DeMarco/MAU-1.0/Hardware/Gerbers/Altimeter6 - bottom.jpg

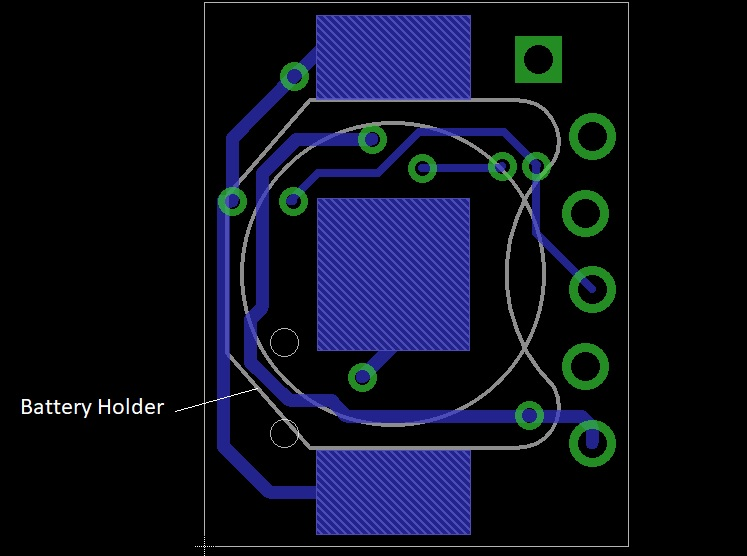
Hardware/Gerbers/Altimeter6 - bottom.jpg
