DeMarco/MAU-1.0/Hardware/Gerbers/Altimeter6 - top.jpg

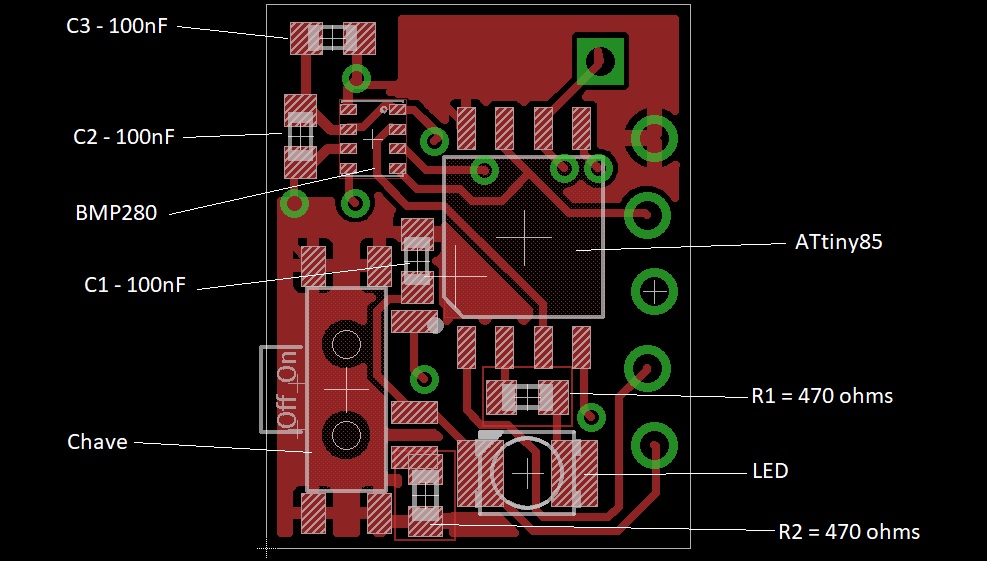
Hardware/Gerbers/Altimeter6 - top.jpg
