DeMarco/MAU-1.0/Hardware/Gerbers/Schematic Adapter.JPG

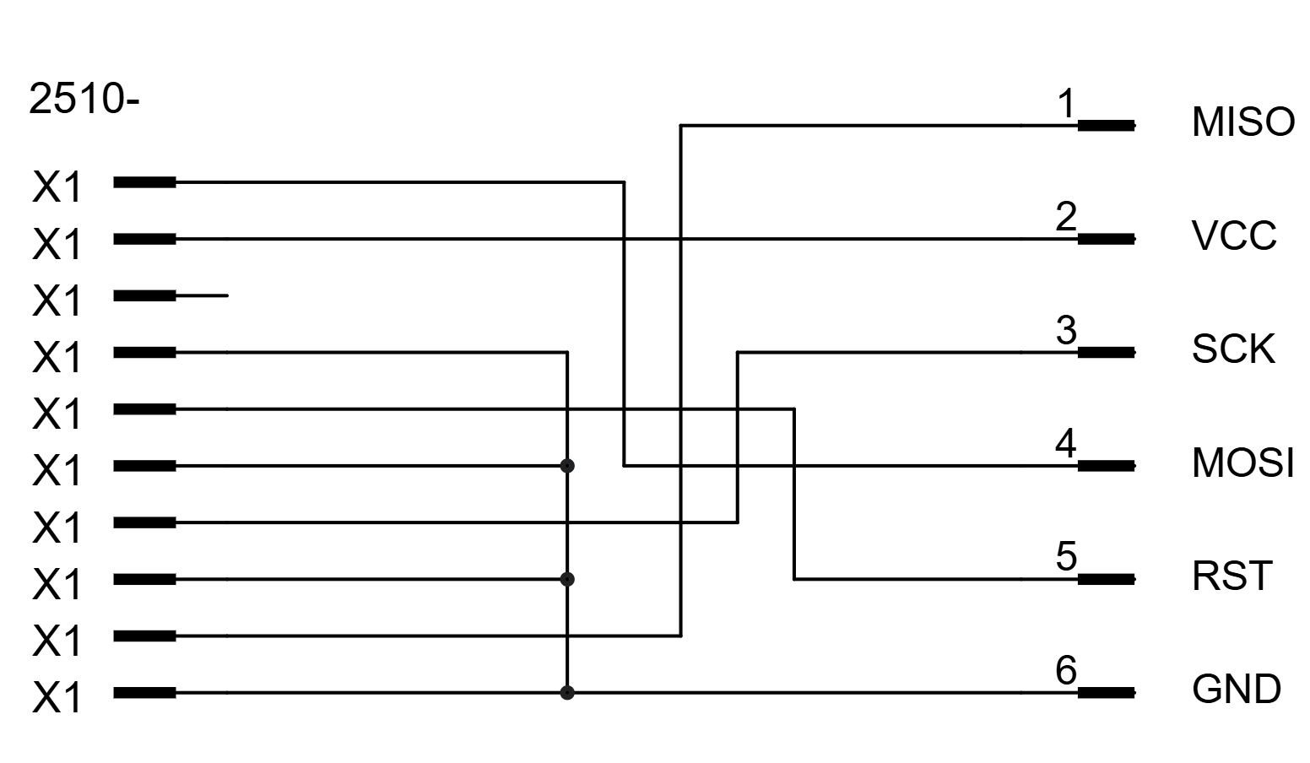
Hardware/Gerbers/Schematic Adapter.JPG
