DeMarco/MAU-1.0/Hardware/Gerbers/Schematic Altimeter.JPG

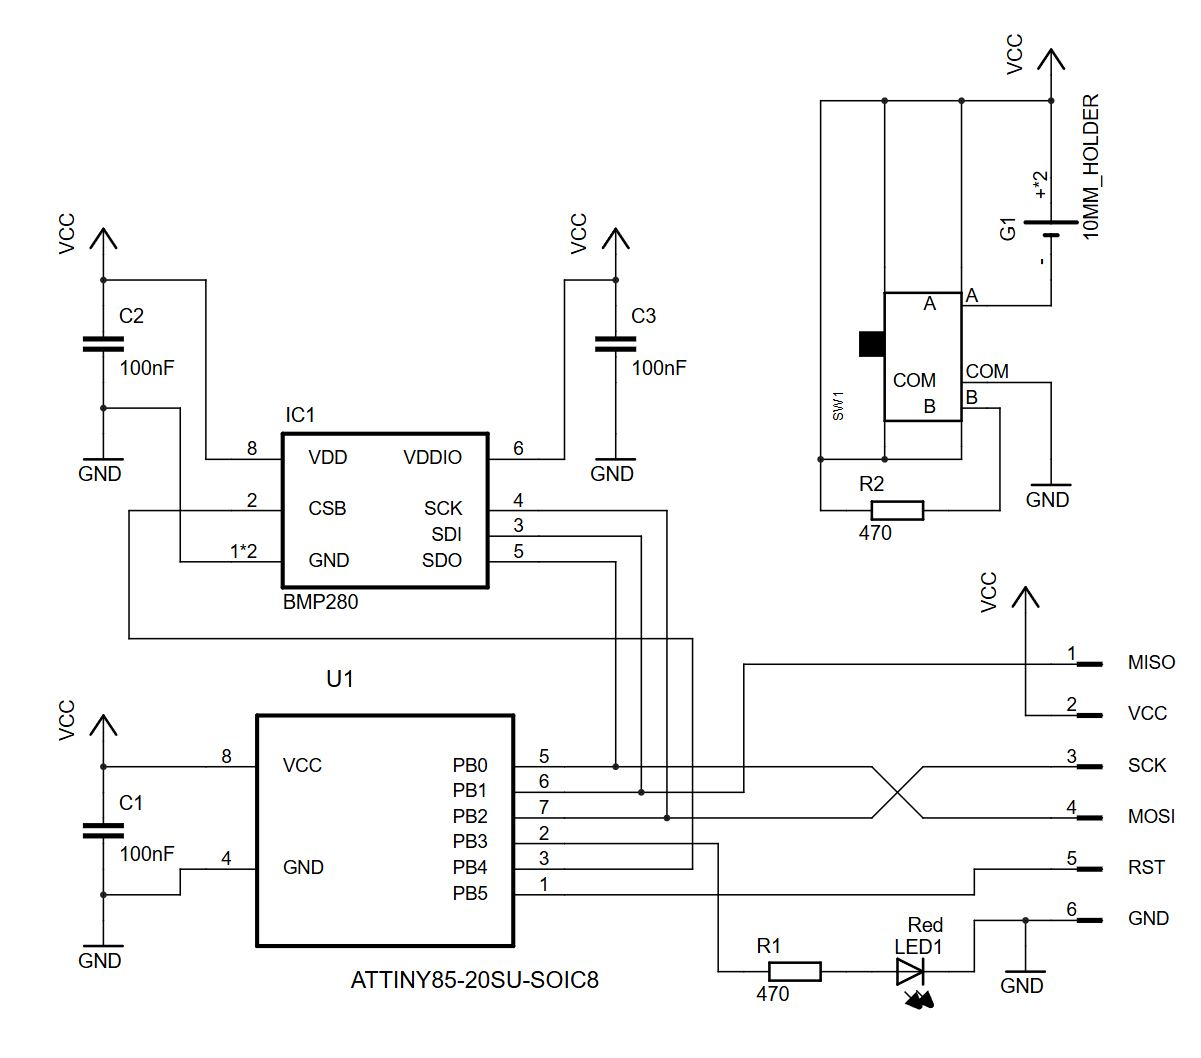
Hardware/Gerbers/Schematic Altimeter.JPG
