DeMarco/MAU-1.0/Hardware/ISP Bottom.jpg

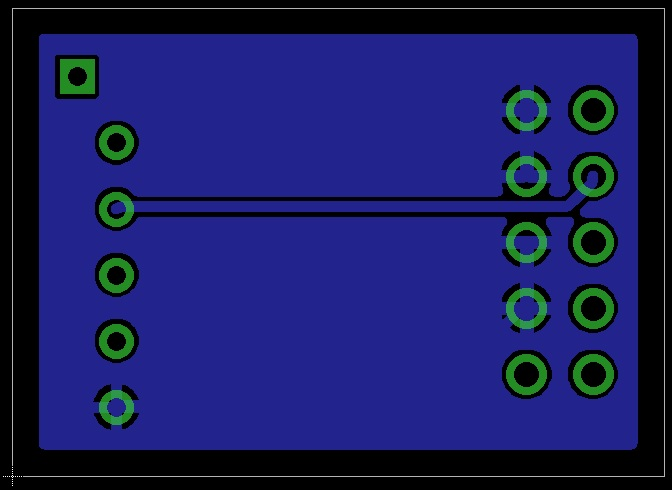
Hardware/ISP Bottom.jpg
