DeMarco/MAU-1.0/Hardware/ISP Top.jpg

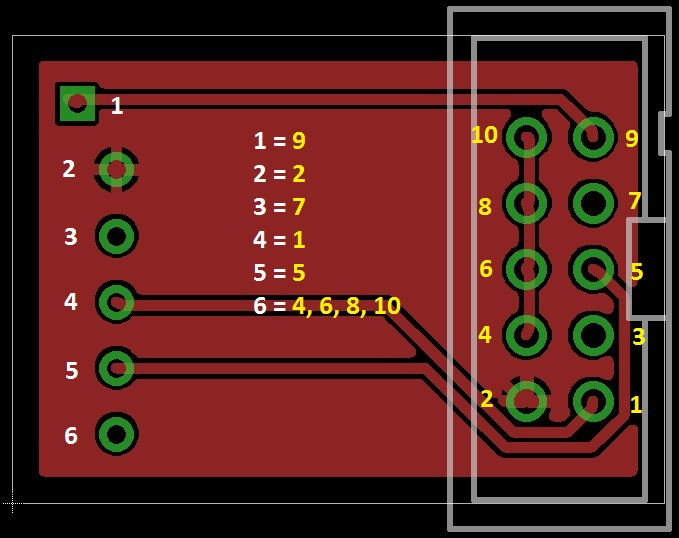
Hardware/ISP Top.jpg
