DeMarco/MAU-1.0/Hardware/Gerbers/lista de componentes MAU.xlsx

 | Descrição | Modelo | Package | Fabricante | Quantidade por placa
ALTÍMETRO | Barômetro | BMP280 | LGA | Bosch | 1
 | Bateria | CR1025 |  | Panasonic | 1
 | Holder Bateria | BK-870 |  | Memory Protection Devices | 1
 | Microcontrolador | ATTINY85-20SU | SOIC8 | Microchip | 1
 | Capacitor | 100nF | 0603 |  | 3
 | Resistor | 470R | 0603 |  | 2
 | LED | Vermelho | 3528 |  | 1
 | Chave | SSSS811101 |  | ALPS | 1
ADAPTADOR | Conector 10 pinos 3M | 2510-6002UB |  | 3M | 1
 | Pinos (daqueles de barra de pino) |  |  |  | 6
