DeMarco/MAU-1.0/Delivery_Montagem/Leitor_MAU/Leitura Dados De Vôo.xlsm

Sheet: Modelo Atmosférico
Equação Barométrica
P (input) | 101523 |  | 101323.8
h (output) | -16.5
h (input) | 950
P (output) | 90531.76
EQ1_Tb | 288.15 | 15
EQ1_Lb | -0.0065
EQ1_R | 8.31432
EQ1_g | 9.80665
EQ1_M | 0.0289644
EQ1_Pb | 101325
coef1 | 44307
index1 | 0.2119
coef2 | 44330
index2 | 0.1903

Sheet: Leitura Dados de Vôo
Vôo Nº: |  | Data:
 |  |  | Altitude (m)
Pressão no Solo (Pa) |  | 101324,27 | #VALUE! | Apogeu (m)
Pressão no Apogeu (Pa) |  | 101324,27 | #VALUE! | #VALUE!
 | Altímetro
Tempo (s) | Dados Brutos | Pressao | Altitude | Altura
0 |  |  | 0.0 | 0.0
0.192 |  |  | 0.0 | 0.0
0.384 |  |  | 0.0 | 0.0
0.576 |  |  | 0.0 | 0.0
0.768 |  |  | 0.0 | 0.0
0.96 |  |  | 0.0 | 0.0
1.152 |  |  | 0.0 | 0.0
1.344 |  |  | 0.0 | 0.0
1.536 |  |  | 0.0 | 0.0
1.728 |  |  | 0.0 | 0.0
1.92 |  |  | 0.0 | 0.0
2.112 |  |  | 0.0 | 0.0
2.304 |  |  | 0.0 | 0.0
2.496 |  |  | 0.0 | 0.0
2.688 |  |  | 0.0 | 0.0
2.88 |  |  | 0.0 | 0.0
3.072 |  |  | 0.0 | 0.0
3.264 |  |  | 0.0 | 0.0
3.456 |  |  | 0.0 | 0.0
3.648 |  |  | 0.0 | 0.0
3.84 |  |  | 0.0 | 0.0
4.032 |  |  | 0.0 | 0.0
4.224 |  |  | 0.0 | 0.0
4.416 |  |  | 0.0 | 0.0
4.608 |  |  | 0.0 | 0.0
4.8 |  |  | 0.0 | 0.0
4.992 |  |  | 0.0 | 0.0
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
