DeMarco/MAU-1.0/Notes/accuracy verification.txt

y-y0 = m(x-x0)
h-h0 = m(p-p0)
h = m(p-p0) + h0

90678 = 933 -> 926.6
91262 = 879 -> 873.5

53.5 -> 53.1

89547 = 1036 -> 1030.1
91384 = 868  -> 862.5

168.4 -> 167.6

91226 -> 876.8
91443 -> 857.1

153

839.8
843.6

38

951.9

9349

37

156.5

917

1071

1148

7132

1083

120.8

110.3

1533

1533

141

16
