DeMarco/MAU-1.0/Notes/Teste SPI BMP280.txt

00100111 - CTRL_MEAS
01001000 - CONFIG
01011000 - ID
00000000 - STATUS

01010111 - Press
11100011 - Press
00000000 - Press

123
750
554
359

11111111 11111111 11111111

00100100
00000001
01111111
10111111
11011111
00011111
11100000

00001100
11100000
00000000

01000100
11100000
01000000

2

00000001
