DeMarco/MAU-1.0/(threads)

Thread 8 (2023-03-02):

Sample Rate Change register in EEPROM is not initialized

DeMarco, 2023-03-02:
Sample Rate Change Address register in EEPROM not initialized, and GraphGenerator doesn't check if the value is valid before using it.
Also, if the currently stored flight data didn't need a reduction in sample rate, the Sample Rate Change Address will still contain an address from the last flight that did use a reduced sample rate. This way, the Graph Generator might apply a change in sample rate and timestamps that should not exist.
