DeMarco/MAU-1.0/Hardware/MAU1.brd

## EAGLE design Hardware/MAU1.brd (2018-09-09)

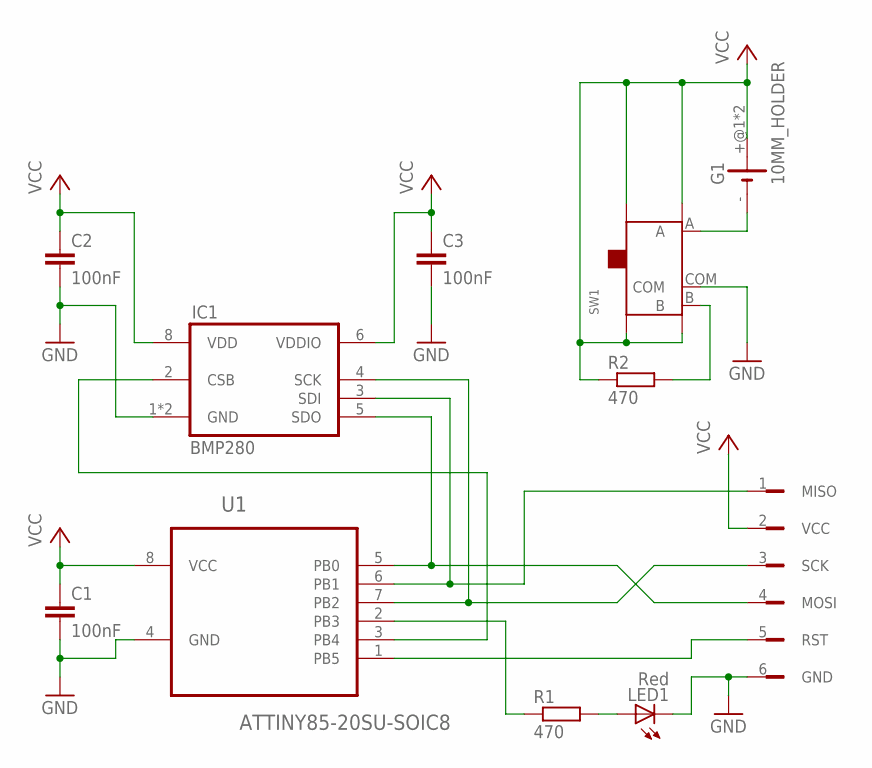
[picture p7: schematic MAU1.sch]

Parts:
C1, C2, C3: 100nF; C0603K
G1: 10MM_HOLDER
IC1: BMP280
LED1: Red; KA-3528ASYC
R1, R2: 470; R0603
SW1: SMD-TOGGLE-SWITCH-ON-ON(3+4P-6.7X2.7MM)SLIDE_LATE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; SW7-SMD-6.7X2.6X1.4MM-90D
U1: ATTINY85-20SU-SOIC8; SOIC8-1.27-5.3X5.3MM
U$1: ISP_CONN_6_FDRILL16; ISP_CONN_6_F_DRILL16

Connections:
GND: C1.2, C2.2, C3.2, IC1.1 (GND), IC1.7 (GND), LED1.C, SW1.COM, U1.4 (GND), U$1.6 (GND)
unnamed: G1.-, SW1.A
unnamed: R1.1, U1.2 (PB3)
unnamed: U1.1 (PB5), U$1.5 (RST)
unnamed: LED1.A, R1.2
unnamed: IC1.2 (CSB), U1.3 (PB4)
unnamed: R2.2, SW1.B
unnamed: IC1.4 (SCK), U1.7 (PB2), U$1.3 (SCK)
unnamed: IC1.3 (SDI), U1.6 (PB1), U$1.1 (MISO)
unnamed: IC1.5 (SDO), U1.5 (PB0), U$1.4 (MOSI)
VCC: C1.1, C2.1, C3.1, G1.+@1 (+), G1.+@2 (+), IC1.6 (VDDIO), IC1.8 (VDD), R2.1, SW1.P1 (SS4), SW1.P2 (SS3), SW1.P3 (SS2), SW1.P4 (SS1), U1.8 (VCC), U$1.2 (VCC)

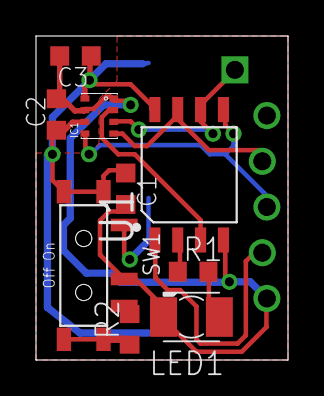
[picture p8: board MAU1.brd from above]

Board: 2 copper layers, 14.0 x 18.0 mm, 11 parts (0 on the bottom side), 11 nets.
