DeMarco/MAU-1.0/Firmware/MainDev/FlightProfile_130.h

// Based on the top part of Uranos flight, between 8 and 22 seconds
// + 40 initial samples for ground pressure averaging:


const uint16_t pressure_samples[] PROGMEM = {

  //Initial samples for ground pressure averaging:
  28259,
  28258,
  28259,
  28257,
  28258,
  28259,
  28258,
  28259,
  28257,
  28258,
  28259,
  28258,
  28259,
  28257,
  28258,
  28259,
  28258,
  28259,
  28257,
  28258,
  28259,
  28258,
  28259,
  28257,
  28258,
  28259,
  28258,
  28259,
  28257,
  28258,
  28259,
  28258,
  28259,
  28257,
  28258,
  28259,
  28258,
  28259,
  28257,
  28258,

  //Recorded flight:
  28259,
  28287,
  28320,
  28347,
  28373,
  28400,
  28425,
  28445,
  28465,
  28484,
  28501,
  28515,
  28529,
  28542,
  28553,
  28563,
  28572,
  28579,
  28585,
  28589,
  28592,
  28591,
  28591,
  28648,
  28671,
  28648,
  28678,
  28637,
  28621,
  28615,
  28610,
  28595,
  28593,
  28585,
  28582,
  28578,
  28573,
  28573,
  28565,
  28561,
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

};
