DeMarco/MAU-1.0/Firmware/MainDev/FlightProfile_500.h

// Based on the top part of Uranos flight, between 8 and 22 seconds
// + 27 initial samples for ground pressure averaging:


const uint16_t pressure_samples[] PROGMEM = {

  //Initial samples for ground pressure averaging:
  24100,
  24101,
  24102,
  24101,
  24100,
  24099,
  24098,
  24099,
  24100,
  24101,
  24102,
  24101,
  24100,
  24099,
  24098,
  24099,
  24100,
  24101,
  24102,
  24101,
  24100,
  24099,
  24098,
  24099,
  24100,
  24101,
  24102,
  24101,

  //Recorded flight:
  24100,
  24200,
  24300,
  24400,
  24500,
  24600,
  24700,
  24800,
  24900,
  25000,
  25100,
  25200,
  25300,
  25400,
  25500,
  25600,
  25700,
  25800,
  25900,
  26000,
  26100,
  26180,
  26260,
  26330,
  26400,
  26450,
  26500,
  26487,
  26474,
  26461,
  26448,
  26435,
  26422,
  26409,
  26396,
  26383,
  26370,
  26357,
  26344,
  26331,
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

};
