DeMarco/MAU-1.0/Firmware/MainDev/FlightProfile_Urano.h

// Based on the 214 first raw pressure samples of the Urano flight
// + 30 initial samples for ground pressure averaging:


const uint16_t pressure_samples[] PROGMEM = {

  //Initial samples for ground pressure averaging:
  25097,
  25097,
  25098,
  25099,
  25100,
  25101,
  25100,
  25099,
  25098,
  25097,
  25097,
  25098,
  25099,
  25100,
  25101,
  25092,
  25092,
  25093,
  25094,
  25095,
  25096,
  25095,
  25094,
  25093,
  25092,
  25092,
  25093,
  25094,
  25095,
  25096,

  //Recorded flight:
  25096,
  25082,
  25053,
  24853,
  24913,
  25050,
  25220,
  25384,
  25557,
  25708,
  25858,
  25986,
  26128,
  26242,
  26368,
  26479,
  26585,
  26697,
  26797,
  26892,
  26982,
  27070,
  27155,
  27234,
  27315,
  27381,
  27458,
  27525,
  27591,
  27654,
  27713,
  27770,
  27824,
  27881,
  27931,
  27979,
  28022,
  28069,
  28108,
  28153,
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

};
