DeMarco/MAU-1.0/Firmware/MainDev/AtmosModel_100_v3.h

// Atmospheric model for altimeter
// Linear approximation with 100 intervals
// Range: 30 kPa (9165.4 m) to 110 kPa (-698.4 m)
// Formula: h = (T0/L0)*(pow((P/P0),((-R*L0)/(g*M)))-1)
// Assumptions:	P0 = 101325 Pa
//					    g = 9,80665 m/s^2
//					    T0 = 15 degC
//					    L0 = -0,0065 K/m
//					    R = 8,31432 N*m/Mol*K
//					    M = 0,0289644 kg/Mol

#define SENSOR_MAX_PRESSURE 	  110000	//Pa
#define SENSOR_MIN_PRESSURE 	  30000	  //Pa
#define PRESSURE_STEP		        800		  //Pa
#define NUMBER_OF_INTERVALS     100
#define NUMBER_OF_BREAKPOINTS	  NUMBER_OF_INTERVALS + 1

const float height_array[NUMBER_OF_BREAKPOINTS] PROGMEM = {
-698.3,
-635.8,
-573.0,
-509.7,
-446.1,
-382.1,
-317.7,
-252.9,
-187.7,
-122.1,
-56.0,
10.4,
77.3,
144.6,
212.3,
280.5,
349.2,
418.3,
487.9,
557.9,
628.4,
699.4,
770.9,
842.9,
915.5,
988.5,
1062.1,
1136.2,
1210.8,
1286.0,
1361.8,
1438.1,
1515.0,
1592.6,
1670.7,
1749.4,
1828.8,
1908.8,
1989.4,
2070.7,
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
};
