DeMarco/MAU-1.0/Firmware/PrototypeOne/AtmosModel_100.c

// Atmospheric model for altimeter
// 100 elements piece-wise linear aproximation
// Range: 30 kPa (9165.4 m) to 110 kPa (-698.4 m)
// Equation: h = 44330 * (1 - pow(P/P0, 0.1903))
// Considerations:	P0 = 101325 Pa
//					g = 9,80665 m/s^2
//					T0 = 15ºC
//					L0 = -0,0065 K/m
//					R = 8,31432 N*m/Mol*K
//					M = 0,0289644 kg/Mol

uint32_t press_max = 110000, press_min = 30000;

float h_breakpoints[101] = {
-698.4,
-635.9,
-573.1,
-509.8,
-446.2,
-382.2,
-317.7,
-252.9,
-187.7,
-122.1,
-56.0,
10.4,
77.3,
144.6,
212.4,
280.6,
349.2,
418.4,
487.9,
558.0,
628.5,
699.5,
771.1,
843.1,
915.6,
988.7,
1062.3,
1136.4,
1211.0,
1286.2,
1362.0,
1438.4,
1515.3,
1592.8,
1671.0,
1749.7,
1829.1,
1909.1,
1989.7,
2071.0,
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
};
