DeMarco/MAU-1.0/(commit log)

2018-07-29 Commiting project relevant files
    [CALCULO TEMP.xlsx, Calculos.xlsx, Formulas de altitude e pressào.xlsx, Leitura Dados De Vôo - 2.xlsx, Leitura Dados De Vôo.xlsm, PiecewiseLinear.xls, TEMPLATE - Leitura Dados De Vôo.xlsx]
2018-07-29 Moved to correct folder in PC
    [CALCULO TEMP.xlsx, Calculos.xlsx, Formulas de altitude e pressào.xlsx, Leitura Dados De Vôo - 2.xlsx, Leitura Dados De Vôo.xlsm, PiecewiseLinear.xls, TEMPLATE - Leitura Dados De Vôo.xlsx]
2018-08-17 Moved stuff to Notes folder
    [CALCULO TEMP.xlsx, Calculos.xlsx, Formulas de altitude e pressào.xlsx, PiecewiseLinear.xls]
2018-09-09 Brought HW project to main repo
    [ISP_adapter2.brd, ISP_adapter2.sch, MAU1.brd, MAU1.sch]
2019-02-02 Prepared MainDev project for continuing development. PrototypeOne is now a frozen version of the firmware of MAU-1.0 currently released to production.
2019-02-02 Placing fluxogram files at MainDev, PrototypeOne and GraphGenerator folders
2019-02-03 Translated firmware comments and flowcharts
2019-02-03 Deleted old portuguese firmware flowcharts
2019-02-04 Update MAIN FLOWCHART.html
    Included step for saving barometers calibration constants before auto shut down.
2019-02-10 Fixed bugs caused by the renaming of def constants in the atmospheric model header. Added batches to MainDev folder for quickly flashing the firmware and erasing the EEPROM.
    [main.c]
2019-02-10 Added comment questioning the zeroing (in meters) of the first sample in the NVM.
2019-03-03 Updated Main Flowchart with method to calculate Initial Ground Pressure and Landing Detection based on 20 raw pressure samples variance.
2019-03-03 Fixed landing detection condition to be just "variance < value", since variance can never be negative.
    [main.c]
2019-07-12 Flex Sampling Rate new feature merge (#7)
    * Strategy for parachute descent detection and sampling rate reduction.
    * Preparations for flexible sampling rate implementation. TESTS OK.
    * Average pressure change rate based variance calculation is ready.
    * Pressure change rate + its variance as conditions for landing detection. In the current state, the program works fine for tests in the glass jar (thus, expected to work for short quick flights), but it is using 7966 bytes from the flash already.
    * Step to record in NVM sample index that marks the sample rate reduction.
    * Fixed missing "false" flow indicators.
    * Reorganized EEPROM addresses in test mode to not disrupt the Excel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
    [Leitura Dados De Vôo - 2.xlsx, Leitura Dados De Vôo - V1.1.xlsm, Leitura Dados De Vôo.xlsm, TEMPLATE - Leitura Dados De Vôo.xlsx, Urano_PR-14_ml-4_LT-2018-08-06_ALTERADO.xlsm]
2025-01-20 Added Gerber files and some example images
    [lista de componentes MAU.xlsx]
